antelliJ/Universal-Remote/3d-Model/Remote-Model.step

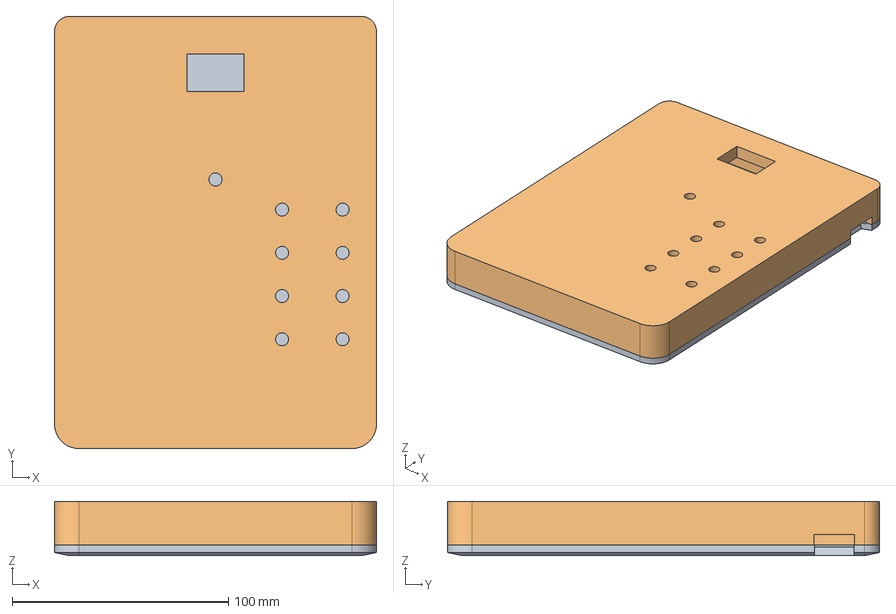
[picture p4: CAD file, 2026-10-10]
3d-Model/Remote-Model.step
149.0 x 200.0 x 25.2 mm
BackBody
FrontBody
