antelliJ/Universal-Remote/(list of files, cad)

Other CAD files:
3d-Model/RemoteModelTest1.FCStd
