antelliJ/Universal-Remote/src/irDump.hpp

// taken from the example sketch

#include <Arduino.h>
#include <assert.h>
#include <IRrecv.h>
#include <IRremoteESP8266.h>
#include <IRac.h>
#include <IRtext.h>
#include <IRutils.h>


const uint16_t kRecvPin = 4;


// As this program is a special purpose capture/decoder, let us use a larger
// than normal buffer so we can handle Air Conditioner remote codes.
const uint16_t kCaptureBufferSize = 1024;
const uint8_t kTimeout = 50; // 50ms probably better to receive IR from some devices

// Set the smallest sized "UNKNOWN" message packets we actually care about.
// This value helps reduce the false-positive detection rate of IR background
// noise as real messages. The chances of background IR noise getting detected
// as a message increases with the length of the kTimeout value. (See above)
// The downside of setting this message too large is you can miss some valid
// short messages for protocols that this library doesn't yet decode.
//
// Set higher if you get lots of random short UNKNOWN messages when nothing
// should be sending a message.
// Set lower if you are sure your setup is working, but it doesn't see messages
// from your device. (e.g. Other IR remotes work.)
// NOTE: Set this value very high to effectively turn off UNKNOWN detection.
const uint16_t kMinUnknownSize = 12;








// Use turn on the save buffer feature for more complete capture coverage.
IRrecv irrecv(kRecvPin, kCaptureBufferSize, kTimeout, true);
decode_results results;  // Somewhere to store the results

void IRRECSetup(){
    irrecv.enableIRIn();  // Start the receiver
}


void IRRECLoop(){
    if (irrecv.decode(&results)) {
        if (results.overflow)
            Serial.printf(D_WARN_BUFFERFULL "\n", kCaptureBufferSize);
        Serial.print(resultToHumanReadableBasic(&results));
        Serial.println(results.value, HEX);
        // irrecv.resume();  // Receive the next value
        
        // Output the results as source code
        Serial.println(resultToSourceCode(&results));
        Serial.println();    // Blank line between entries
        yield();             // Feed the WDT (again)
    }
}
