antelliJ/Universal-Remote/(commit log)

2026-08-04 Include basic BLE framwork, decentralize IR LED hold on main
2026-08-08 Integrated lots of stuff w/ main and screen and states to load and transfer
    Also added some placeholder profiles just to test if everything works.
    Currently things compile, so hopefully its good
2026-08-24 More robust IR and Encoder logic, added IR cmds and profiles
2026-08-25 README addition
    Made sharp and sony device profile
2026-08-26 Readme Overhaul, Included schematics
    Started readme in like last commit but half done then and other half done now
2026-08-28 Minor Fixes and AI usage declaration
    Made the commands a bit clearer
    [btControls.hpp, main.cpp]
2026-10-10 Step file and BOM included in README and respective directory
2026-10-10 Restructure folders and include BOM
2026-10-10 Added cad model to diagram
2026-10-10 Improve clarity of solder and BOM notes
    Reformat notes on solder and BOM file for clarity.
2026-10-10 Put another copy of schematic into the resoucres folder
